icl-rocketry/Ricardo-Garnet/Hardware/Ricardo-Garnet.kicad_pcb

## KiCad design Hardware/Ricardo-Garnet.kicad_pcb (2026-05-12)

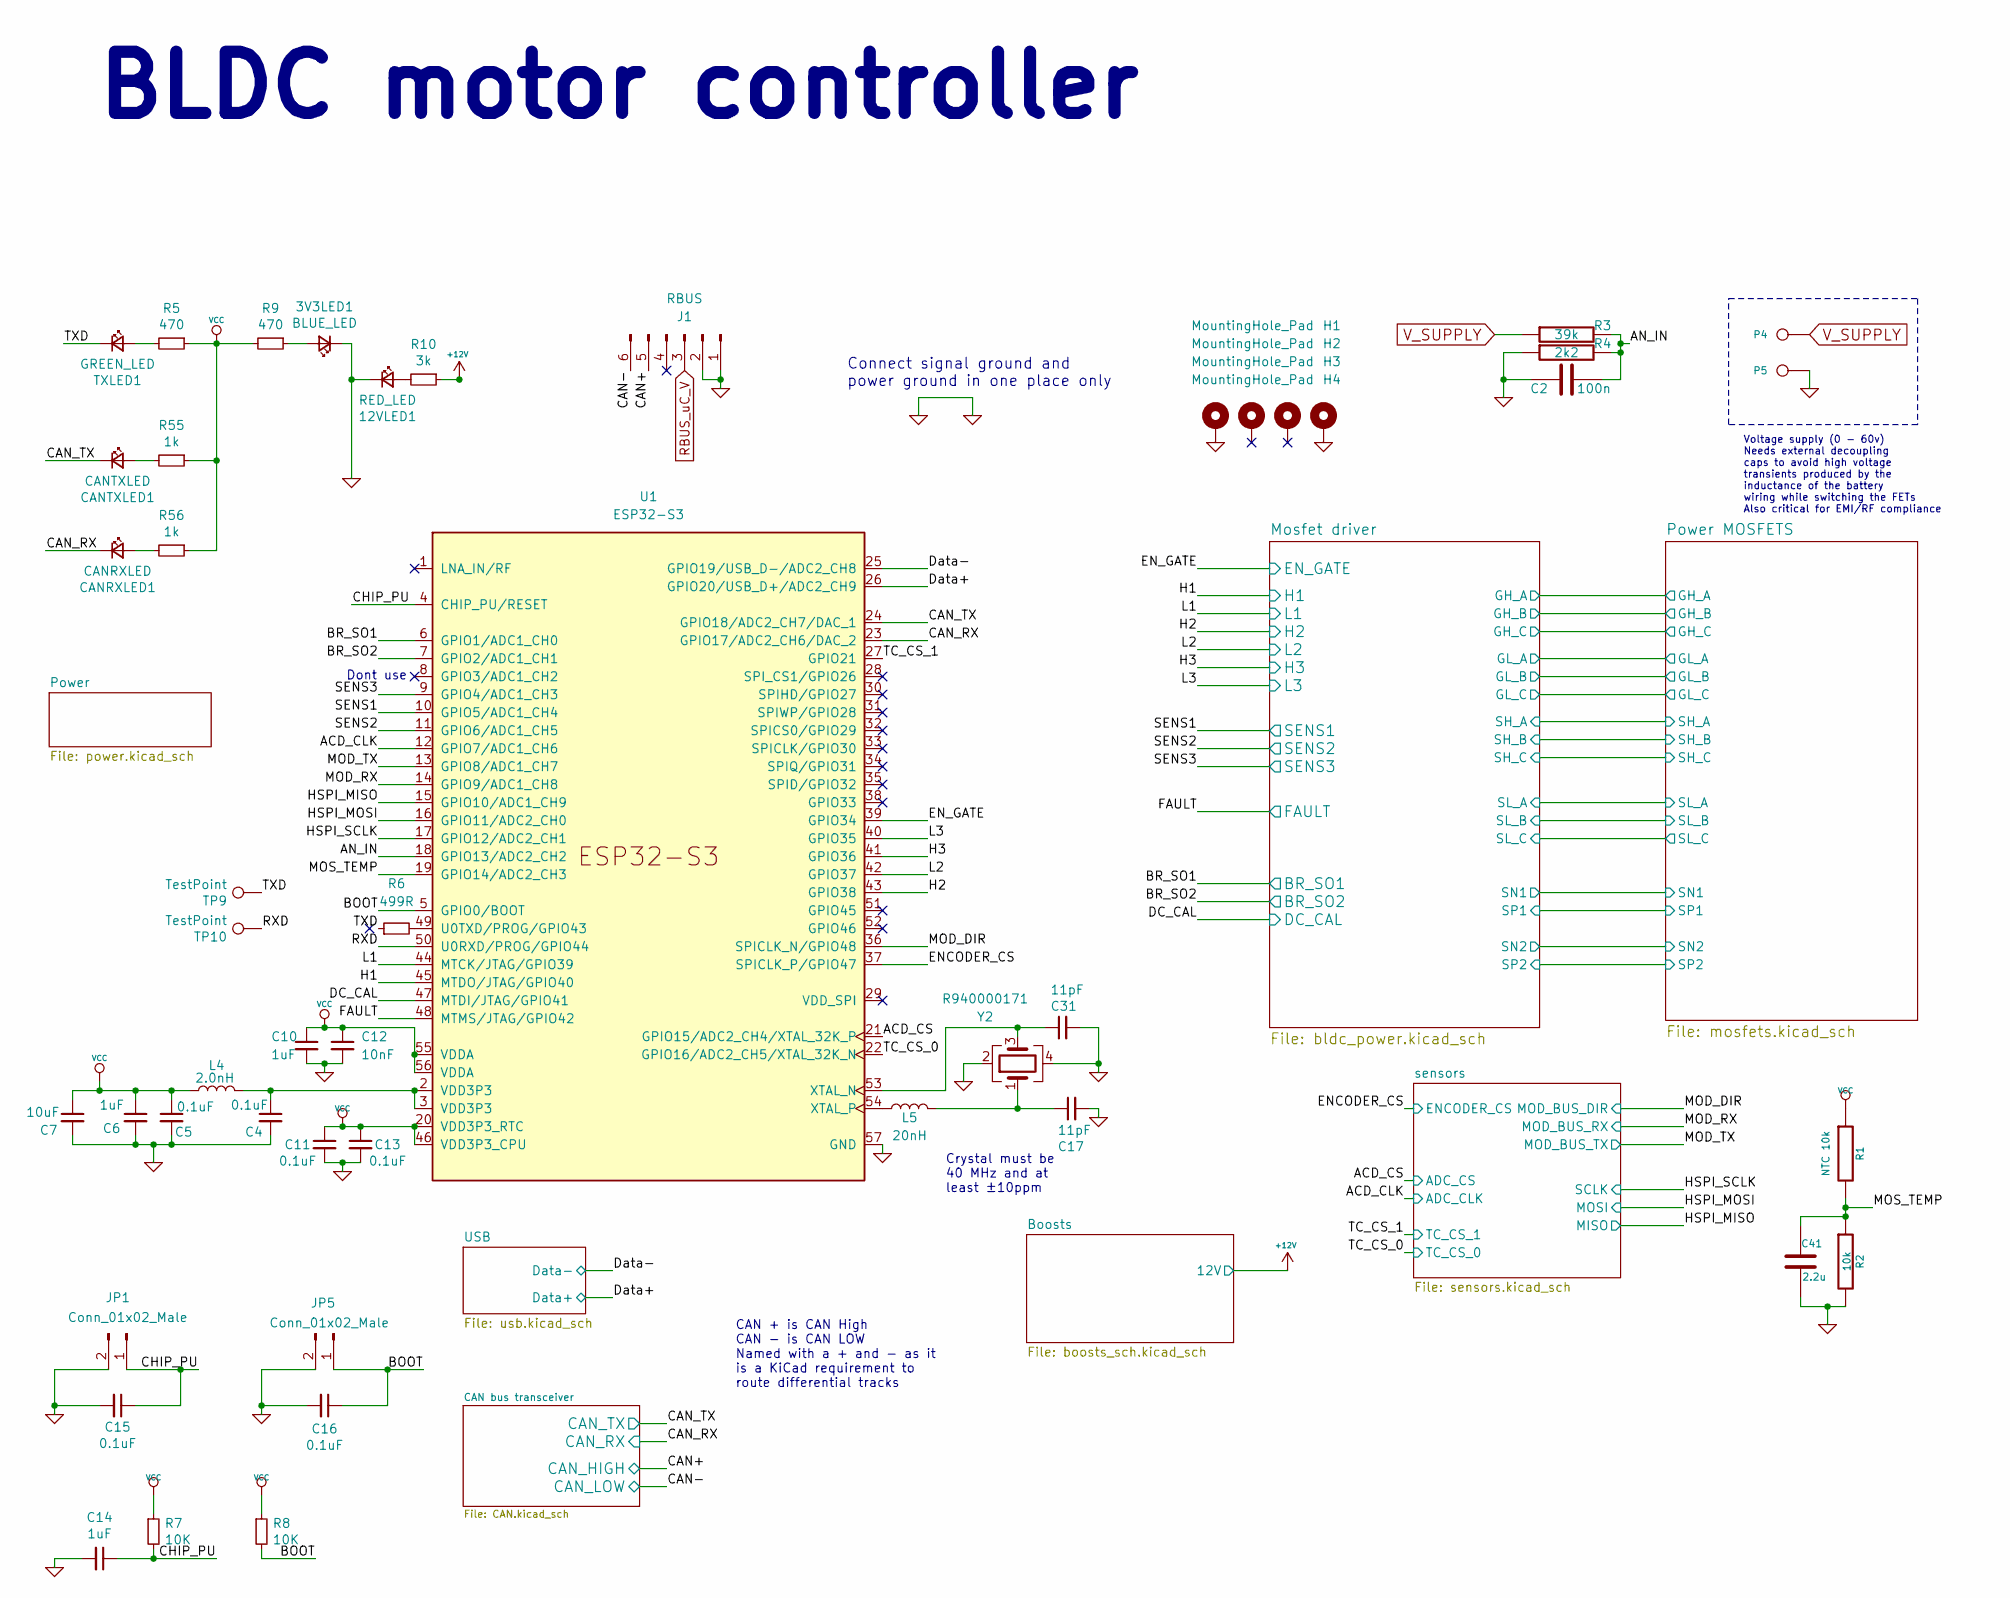
[picture p1: schematic Ricardo-Garnet.kicad_sch]

Parts:
3V3LED1: BLUE_LED; LED_0402_1005Metric
12VLED1: RED_LED; LED_0402_1005Metric
C2: 100n; C_0603_1608Metric
C4, C5, C11, C13, C15, C16: 0.1uF; C_0402_1005Metric
C6, C10, C14: 1uF; C_0402_1005Metric
C7: 10uF; C_0402_1005Metric
C12: 10nF; C_0402_1005Metric
C17, C31: 11pF; C_0402_1005Metric
C41: 2.2u; C_0603_1608Metric
CANRXLED1: CANRXLED; LED_0402_1005Metric
CANTXLED1: CANTXLED; LED_0402_1005Metric
H1, H2, H3, H4: MountingHole_Pad; MountingHole_3.2mm_M3_DIN965_Pad
J1: RBUS; Molex_Mini-Fit_Jr_5569-06A2_2x03_P4.20mm_Horizontal
JP1, JP5: Conn_01x02_Male; PinHeader_1x02_P2.54mm_Vertical
L4: 2.0nH; L_0402_1005Metric
L5: 20nH; L_0402_1005Metric
P4: IN+; 1PAD_4x5mm
P5: IN-; 1PAD_4x5mm
R1: NTC 10k; R_0603_1608Metric
R2: 10k; R_0402_1005Metric
R3: 39k; R_0603_1608Metric
R4: 2k2; R_0402_1005Metric
R5, R9: 470; R_0402_1005Metric
R6: 499R; R_0402_1005Metric
R7, R8: 10K; R_0402_1005Metric
R10: 3k; R_0402_1005Metric
R55, R56: 1k; R_0402_1005Metric
TP9, TP10: TestPoint; TestPoint_Pad_D1.0mm
TXLED1: GREEN_LED; LED_0402_1005Metric
U1: ESP32-S3; QFN40P700X700X90-57N
Y2: R940000171; Crystal_SMD_2016-4Pin_2.0x1.6mm

Connections:
+12V: R10.1; also elsewhere on the board
/ACD_CLK: U1.12 (GPIO7/ADC1_CH6); also elsewhere on the board
/ACD_CS: U1.21 (GPIO15/ADC2_CH4/XTAL_32K_P); also elsewhere on the board
/AN_IN: C2.2, R3.2, R4.2, U1.18 (GPIO13/ADC2_CH2)
/BOOT: C16.1, JP5.1, R8.2, U1.5 (GPIO0/BOOT)
/BR_SO1: U1.6 (GPIO1/ADC1_CH0); also elsewhere on the board
/BR_SO2: U1.7 (GPIO2/ADC1_CH1); also elsewhere on the board
/CAN+: J1.5; also elsewhere on the board
/CAN-: J1.6; also elsewhere on the board
/CAN_RX: CANRXLED1.1 (K), U1.23 (GPIO17/ADC2_CH6/DAC_2); also elsewhere on the board
/CAN_TX: CANTXLED1.1 (K), U1.24 (GPIO18/ADC2_CH7/DAC_1); also elsewhere on the board
/CHIP_PU: C14.1, C15.1, JP1.1, R7.2, U1.4 (CHIP_PU/RESET)
/DC_CAL: U1.47 (MTDI/JTAG/GPIO41); also elsewhere on the board
/Data+: U1.26 (GPIO20/USB_D+/ADC2_CH9); also elsewhere on the board
/Data-: U1.25 (GPIO19/USB_D-/ADC2_CH8); also elsewhere on the board
/ENCODER_CS: U1.37 (SPICLK_P/GPIO47); also elsewhere on the board
/EN_GATE: U1.39 (GPIO34); also elsewhere on the board
/FAULT: U1.48 (MTMS/JTAG/GPIO42); also elsewhere on the board
/H1: U1.45 (MTDO/JTAG/GPIO40); also elsewhere on the board
/H2: U1.43 (GPIO38); also elsewhere on the board
/H3: U1.41 (GPIO36); also elsewhere on the board
/HSPI_MISO: U1.15 (GPIO10/ADC1_CH9); also elsewhere on the board
/HSPI_MOSI: U1.16 (GPIO11/ADC2_CH0); also elsewhere on the board
/HSPI_SCLK: U1.17 (GPIO12/ADC2_CH1); also elsewhere on the board
/L1: U1.44 (MTCK/JTAG/GPIO39); also elsewhere on the board
/L2: U1.42 (GPIO37); also elsewhere on the board
/L3: U1.40 (GPIO35); also elsewhere on the board
/MOD_DIR: U1.36 (SPICLK_N/GPIO48); also elsewhere on the board
/MOD_RX: U1.14 (GPIO9/ADC1_CH8); also elsewhere on the board
/MOD_TX: U1.13 (GPIO8/ADC1_CH7); also elsewhere on the board
/MOS_TEMP: C41.1, R1.2, R2.1, U1.19 (GPIO14/ADC2_CH3)
/RXD: TP10.1, U1.50 (U0RXD/PROG/GPIO44)
/SENS1: U1.10 (GPIO5/ADC1_CH4); also elsewhere on the board
/SENS2: U1.11 (GPIO6/ADC1_CH5); also elsewhere on the board
/SENS3: U1.9 (GPIO4/ADC1_CH3); also elsewhere on the board
/TC_CS_0: U1.22 (GPIO16/ADC2_CH5/XTAL_32K_N); also elsewhere on the board
/TC_CS_1: U1.27 (GPIO21); also elsewhere on the board
/TXD: R6.1, TP9.1, TXLED1.1 (K)
GND: 3V3LED1.1 (K), 12VLED1.1 (K), C2.1, C4.2, C5.2, C6.2, C7.2, C10.2, C11.2, C12.2, C13.2, C14.2, C15.2, C16.2, C17.2, C31.2, C41.2, H1.1, H4.1, J1.1, J1.2, JP1.2, JP5.2, P5.1, R2.2, R4.1, U1.57 (GND), Y2.2, Y2.4; also elsewhere on the board
unnamed: 3V3LED1.2 (A), R9.1
unnamed: 12VLED1.2 (A), R10.2
unnamed: C4.1, L4.2, U1.2 (VDD3P3), U1.3 (VDD3P3)
unnamed: C17.1, L5.2, Y2.1
unnamed: CANRXLED1.2 (A), R56.2
unnamed: CANTXLED1.2 (A), R55.2
unnamed: R5.2, TXLED1.2 (A)
unnamed: R6.2, U1.49 (U0TXD/PROG/GPIO43)
unnamed: C31.1, U1.53 (XTAL_N), Y2.3
unnamed: L5.1, U1.54 (XTAL_P)
RBUS_uC_V: J1.3; also elsewhere on the board
VCC: C5.1, C6.1, C7.1, C10.1, C11.1, C12.1, C13.1, L4.1, R1.1, R5.1, R7.1, R8.1, R9.2, R55.1, R56.1, U1.20 (VDD3P3_RTC), U1.46 (VDD3P3_CPU), U1.55 (VDDA), U1.56 (VDDA); also elsewhere on the board
V_SUPPLY: P4.1, R3.1; also elsewhere on the board

Notes on the sheet:
Connect signal ground and power ground in one place only
Dont use
BLDC motor controller
Voltage supply (0 - 60v) Needs external decoupling caps to avoid high voltage transients produced by the inductance of the battery wiring while switching the FETs Also critical for EMI/RF compliance
CAN + is CAN High CAN - is CAN LOW Named with a + and - as it is a KiCad requirement to route differential tracks
Crystal must be 40 MHz and at least ±10ppm

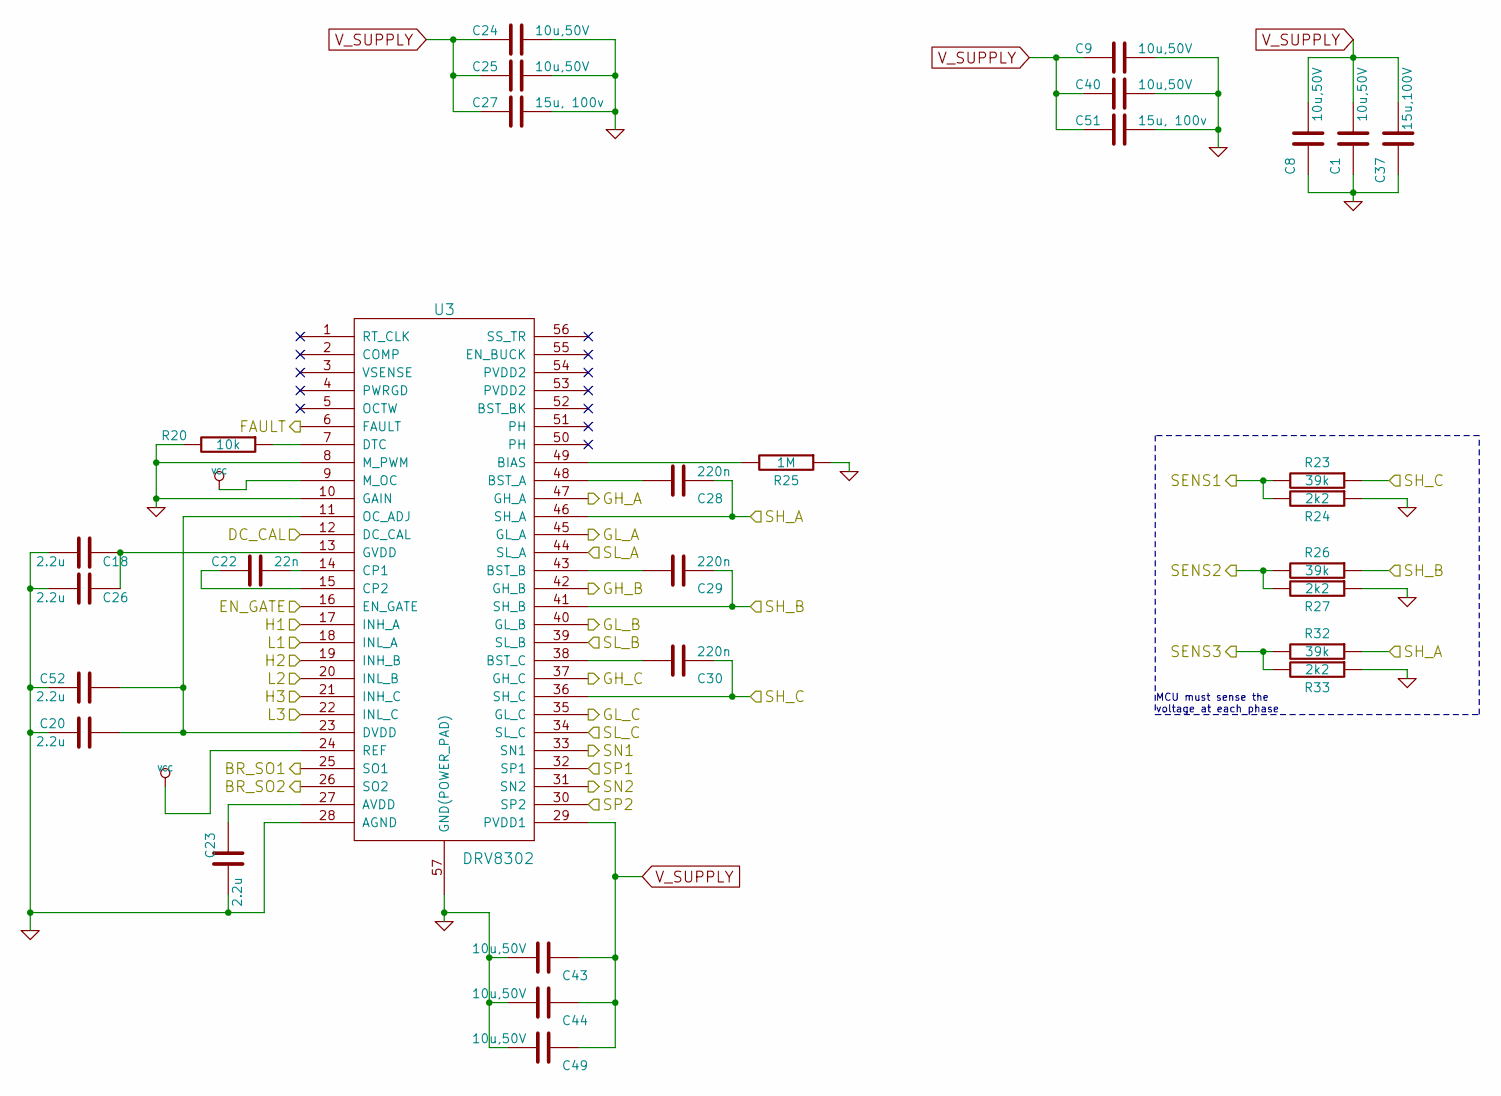
[picture p2: schematic bldc_power.kicad_sch, BLDC Driver 4.11]

Parts:
C1, C8, C9, C24, C25, C40, C43, C44, C49: 10u,50V; C_1206_3216Metric
C18, C20, C23, C26, C52: 2.2u; C_0603_1608Metric
C22: 22n; C_0603_1608Metric
C27, C51: 15u, 100v; C_2220_5750Metric
C28, C29, C30: 220n; C_0603_1608Metric
C37: 15u,100V; C_2220_5750Metric
R20: 10k; R_0402_1005Metric
R23, R26, R32: 39k; R_0603_1608Metric
R24, R27, R33: 2k2; R_0402_1005Metric
R25: 1M; R_0603_1608Metric
U3: DRV8302; TSSOP-56-PP

Connections:
/BR_SO1: U3.25 (SO1); also elsewhere on the board
/BR_SO2: U3.26 (SO2); also elsewhere on the board
/DC_CAL: U3.12 (DC_CAL); also elsewhere on the board
/EN_GATE: U3.16 (EN_GATE); also elsewhere on the board
/FAULT: U3.6 (FAULT); also elsewhere on the board
/H1: U3.17 (INH_A); also elsewhere on the board
/H2: U3.19 (INH_B); also elsewhere on the board
/H3: U3.21 (INH_C); also elsewhere on the board
/L1: U3.18 (INL_A); also elsewhere on the board
/L2: U3.20 (INL_B); also elsewhere on the board
/L3: U3.22 (INL_C); also elsewhere on the board
/Mosfet driver/GH_A: U3.47 (GH_A); also elsewhere on the board
/Mosfet driver/GH_B: U3.42 (GH_B); also elsewhere on the board
/Mosfet driver/GH_C: U3.37 (GH_C); also elsewhere on the board
/Mosfet driver/GL_A: U3.45 (GL_A); also elsewhere on the board
/Mosfet driver/GL_B: U3.40 (GL_B); also elsewhere on the board
/Mosfet driver/GL_C: U3.35 (GL_C); also elsewhere on the board
/Mosfet driver/SH_A: C28.1, R32.1, U3.46 (SH_A); also elsewhere on the board
/Mosfet driver/SH_B: C29.1, R26.1, U3.41 (SH_B); also elsewhere on the board
/Mosfet driver/SH_C: C30.1, R23.1, U3.36 (SH_C); also elsewhere on the board
/Mosfet driver/SL_A: U3.44 (SL_A); also elsewhere on the board
/Mosfet driver/SL_C: U3.34 (SL_C); also elsewhere on the board
/Mosfet driver/SN1: U3.33 (SN1); also elsewhere on the board
/Mosfet driver/SN2: U3.31 (SN2); also elsewhere on the board
/Mosfet driver/SP1: U3.32 (SP1); also elsewhere on the board
/Mosfet driver/SP2: U3.30 (SP2); also elsewhere on the board
/SENS1: R23.2, R24.2; also elsewhere on the board
/SENS2: R26.2, R27.2; also elsewhere on the board
/SENS3: R32.2, R33.2; also elsewhere on the board
GND: C1.1, C8.1, C9.1, C18.1, C20.1, C23.1, C24.1, C25.1, C26.1, C27.1, C37.1, C40.1, C43.2, C44.2, C49.2, C51.1, C52.1, R20.2, R24.1, R25.1, R27.1, R33.1, U3.8 (M_PWM), U3.10 (GAIN), U3.28 (AGND), U3.39 (SL_B), U3.57 (GND(POWER_PAD)); also elsewhere on the board
unnamed: C23.2, U3.27 (AVDD)
unnamed: R25.2, U3.49 (BIAS)
unnamed: C28.2, U3.48 (BST_A)
unnamed: C29.2, U3.43 (BST_B)
unnamed: C30.2, U3.38 (BST_C)
unnamed: C22.1, U3.14 (CP1)
unnamed: C22.2, U3.15 (CP2)
unnamed: R20.1, U3.7 (DTC)
unnamed: C20.2, C52.2, U3.11 (OC_ADJ), U3.23 (DVDD)
unnamed: C18.2, C26.2, U3.13 (GVDD)
VCC: U3.9 (M_OC), U3.24 (REF); also elsewhere on the board
V_SUPPLY: C1.2, C8.2, C9.2, C24.2, C25.2, C27.2, C37.2, C40.2, C43.1, C44.1, C49.1, C51.2, U3.29 (PVDD1); also elsewhere on the board

Notes on the sheet:
MCU must sense the voltage at each phase

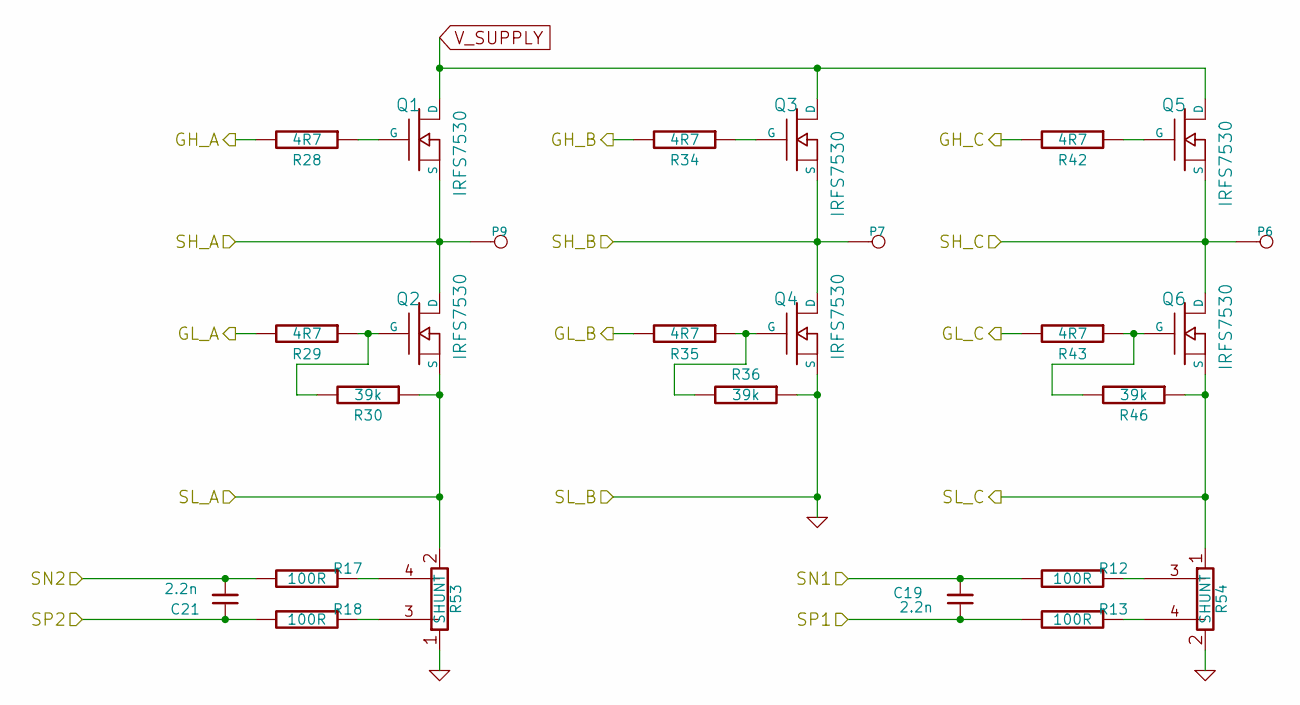
[picture p3: schematic mosfets.kicad_sch, BLDC Driver 4.11]

Parts:
C19, C21: 2.2n; C_0603_1608Metric
P6: MOTOR1; 1PAD_4x5mm
P7: MOTOR2; 1PAD_4x5mm
P9: MOTOR3; 1PAD_4x5mm
Q1, Q2, Q3, Q4, Q5, Q6: IRFS7530; D2PAK-7-GDS
R12, R13, R17, R18: 100R; R_0603_1608Metric
R28, R29, R34, R35, R42, R43: 4R7; R_0603_1608Metric
R30, R36, R46: 39k; R_0603_1608Metric
R53, R54: SHUNT; WSLP2726

Connections:
/Mosfet driver/GH_A: R28.2; also elsewhere on the board
/Mosfet driver/GH_B: R34.2; also elsewhere on the board
/Mosfet driver/GH_C: R42.2; also elsewhere on the board
/Mosfet driver/GL_A: R29.2; also elsewhere on the board
/Mosfet driver/GL_B: R35.2; also elsewhere on the board
/Mosfet driver/GL_C: R43.2; also elsewhere on the board
/Mosfet driver/SH_A: P9.1, Q1.S, Q2.D; also elsewhere on the board
/Mosfet driver/SH_B: P7.1, Q3.S, Q4.D; also elsewhere on the board
/Mosfet driver/SH_C: P6.1, Q5.S, Q6.D; also elsewhere on the board
/Mosfet driver/SL_A: Q2.S, R30.1, R53.2; also elsewhere on the board
/Mosfet driver/SL_C: Q6.S, R46.1, R54.1; also elsewhere on the board
/Mosfet driver/SN1: C19.2, R12.2; also elsewhere on the board
/Mosfet driver/SN2: C21.2, R17.2; also elsewhere on the board
/Mosfet driver/SP1: C19.1, R13.2; also elsewhere on the board
/Mosfet driver/SP2: C21.1, R18.2; also elsewhere on the board
GND: Q4.S, R36.1, R53.1, R54.2; also elsewhere on the board
unnamed: Q1.G, R28.1
unnamed: Q2.G, R29.1, R30.2
unnamed: Q3.G, R34.1
unnamed: Q4.G, R35.1, R36.2
unnamed: Q5.G, R42.1
unnamed: Q6.G, R43.1, R46.2
unnamed: R12.1, R54.3
unnamed: R13.1, R54.4
unnamed: R17.1, R53.4
unnamed: R18.1, R53.3
V_SUPPLY: Q1.D, Q3.D, Q5.D; also elsewhere on the board

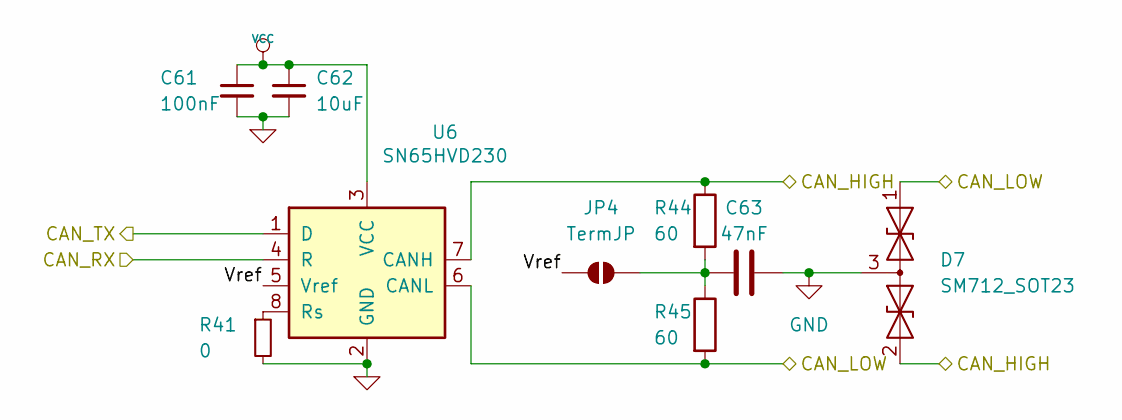
[picture p4: schematic CAN.kicad_sch, BLDC Driver 4.11]

Parts:
C61: 100nF; C_0402_1005Metric
C62: 10uF; C_0402_1005Metric
C63: 47nF; C_0402_1005Metric
D7: SM712_SOT23; SOT-23
JP4: TermJP; SmallerSolderJP
R41: 0; R_0603_1608Metric
R44, R45: 60; R_0603_1608Metric
U6: SN65HVD230; SOIC-8_3.9x4.9mm_P1.27mm

Connections:
/CAN bus transceiver/Vref: JP4.1 (A), U6.5 (Vref)
/CAN+: D7.2 (A2), R44.1, U6.7 (CANH); also elsewhere on the board
/CAN-: D7.1 (A1), R45.2, U6.6 (CANL); also elsewhere on the board
/CAN_RX: U6.4 (R); also elsewhere on the board
/CAN_TX: U6.1 (D); also elsewhere on the board
GND: C61.2, C62.2, C63.2, D7.3 (common), R41.2, U6.2 (GND); also elsewhere on the board
unnamed: C63.1, JP4.2 (B), R44.2, R45.1
unnamed: R41.1, U6.8 (Rs)
VCC: C61.1, C62.1, U6.3 (VCC); also elsewhere on the board

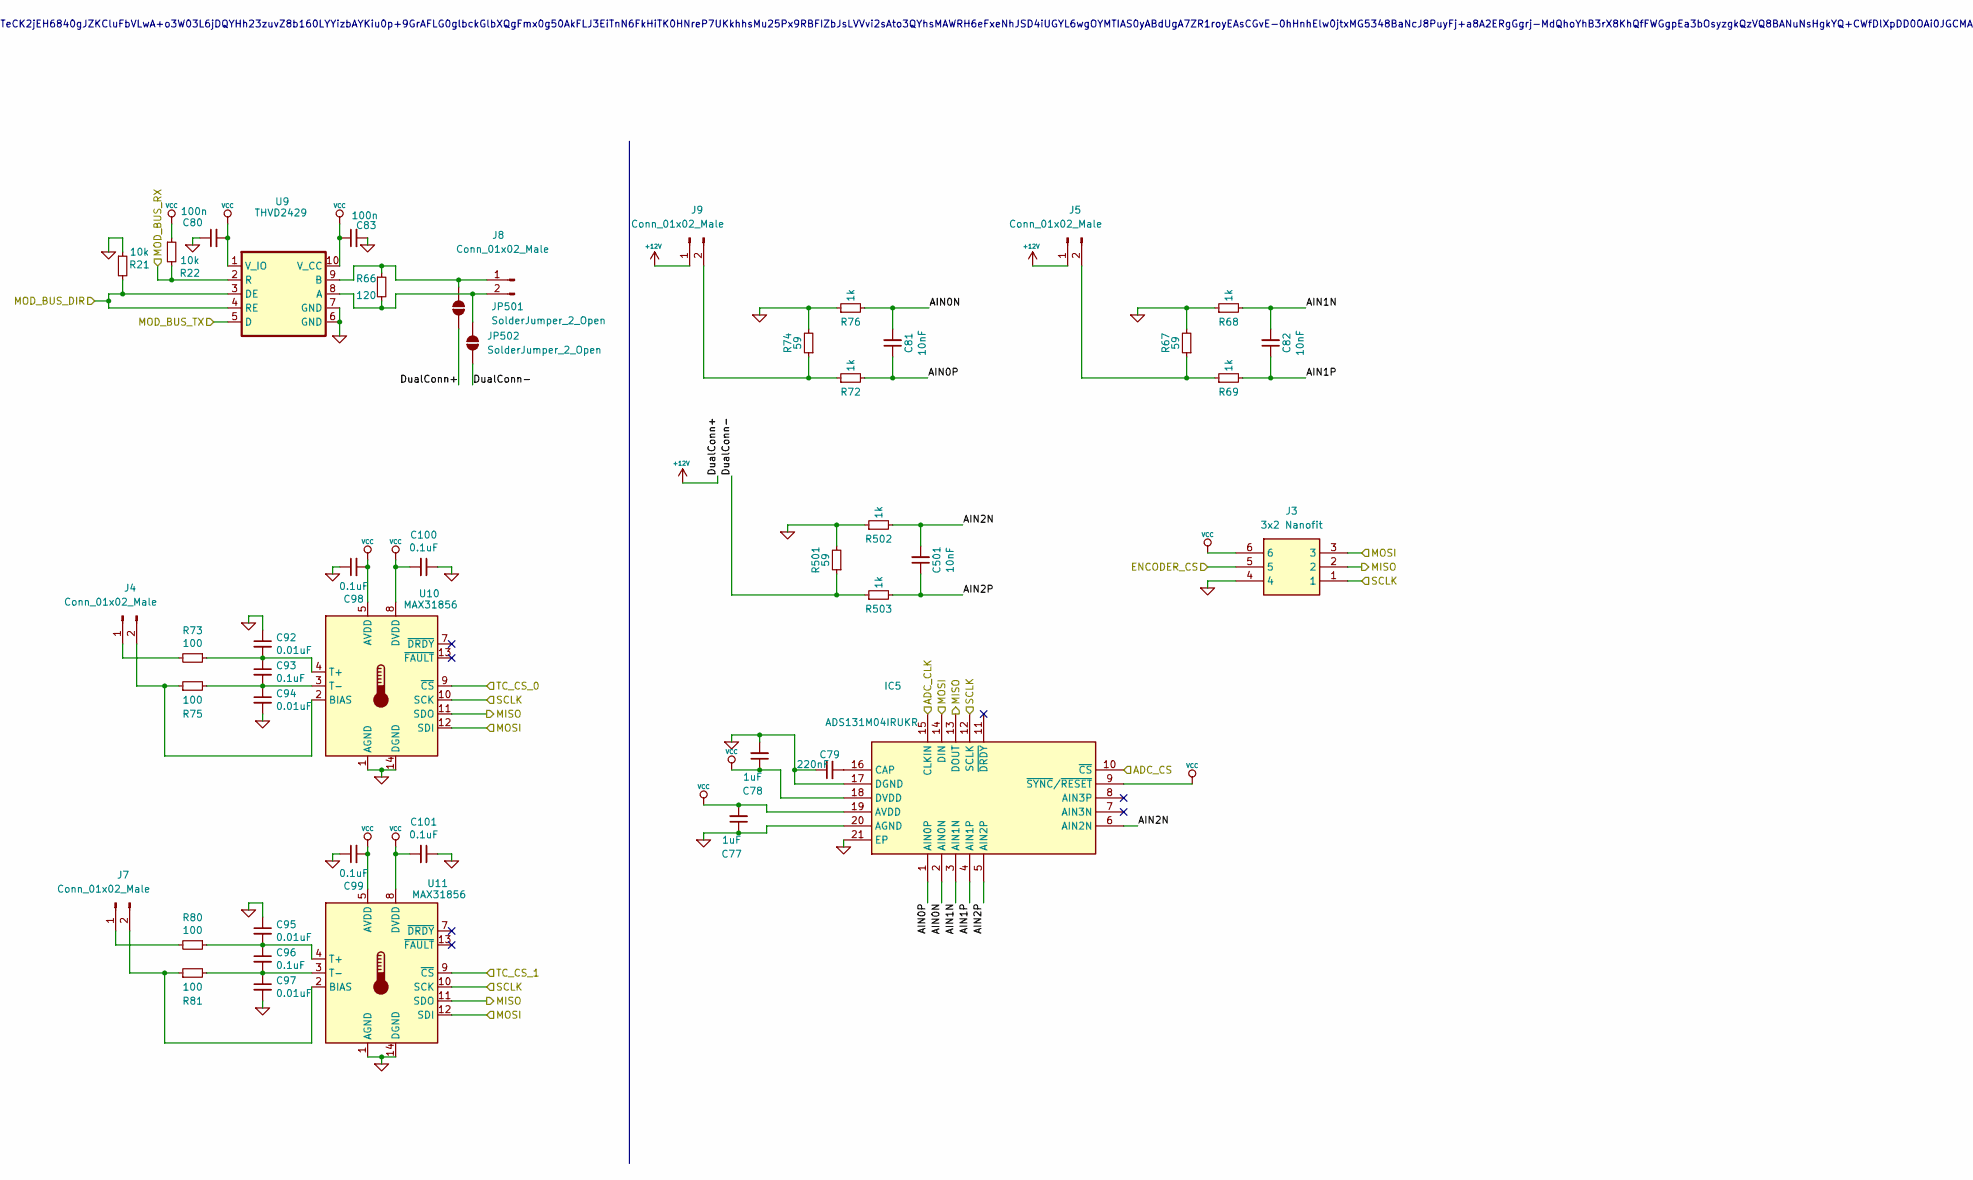
[picture p5: schematic sensors.kicad_sch, part in row 1, column 3]

Parts:
C77, C78: 1uF; C_0402_1005Metric
C79: 220nF; C_0402_1005Metric
C80, C83: 100n; C_0402_1005Metric
C81, C82, C501: 10nF; C_0402_1005Metric
C92, C94, C95, C97: 0.01uF; C_0402_1005Metric
C93, C96, C98, C99, C100, C101: 0.1uF; C_0402_1005Metric
IC5: ADS131M04IRUKR; QFN40P300X300X80-21N-D; Manufacturer_Part_Number ADS131M04IRUKR; Mouser Part Number 595-ADS131M04IRUKR
J3: 3x2 Nanofit; Molex_Nano-Fit_105314-xx06_2x03_P2.50mm_Horizontal; Mouser Part Number 538-105314-1206
J4, J5, J7, J8, J9: Conn_01x02_Male; Molex_Nano-Fit_105313-xx02_1x02_P2.50mm_Horizontal
JP501, JP502: SolderJumper_2_Open; small_2_pad_jumper_open
R21, R22: 10k; R_0402_1005Metric
R66: 120; R_0402_1005Metric
R67, R74, R501: 59; R_0402_1005Metric; MPN RT0402BRD0749R9L
R68, R69, R72, R76, R502, R503: 1k; R_0402_1005Metric
R73, R75, R80, R81: 100; R_0402_1005Metric
U9: THVD2429; TPS74901DRCR
U10, U11: MAX31856; TSSOP-14_4.4x5mm_P0.65mm

Connections:
+12V: J5.1, J9.1, JP501.1 (A); also elsewhere on the board
/ACD_CLK: IC5.15 (CLKIN); also elsewhere on the board
/ACD_CS: IC5.10 (~CS); also elsewhere on the board
/ENCODER_CS: J3.5; also elsewhere on the board
/HSPI_MISO: IC5.13 (DOUT), J3.2, U10.11 (SDO), U11.11 (SDO); also elsewhere on the board
/HSPI_MOSI: IC5.14 (DIN), J3.3, U10.12 (SDI), U11.12 (SDI); also elsewhere on the board
/HSPI_SCLK: IC5.12 (SCLK), J3.1, U10.10 (SCK), U11.10 (SCK); also elsewhere on the board
/MOD_DIR: R21.2, U9.3 (DE), U9.4 (RE); also elsewhere on the board
/MOD_RX: R22.2, U9.2 (R); also elsewhere on the board
/MOD_TX: U9.5 (D); also elsewhere on the board
/TC_CS_0: U10.9 (~CS); also elsewhere on the board
/TC_CS_1: U11.9 (~CS); also elsewhere on the board
/sensors/AIN0N: C81.2, IC5.2 (AIN0N), R76.2
/sensors/AIN0P: C81.1, IC5.1 (AIN0P), R72.2
/sensors/AIN1N: C82.2, IC5.3 (AIN1N), R68.2
/sensors/AIN1P: C82.1, IC5.4 (AIN1P), R69.2
/sensors/AIN2N: C501.2, IC5.6 (AIN2N), R502.2
/sensors/AIN2P: C501.1, IC5.5 (AIN2P), R503.2
/sensors/DualConn-: JP502.1 (A), R501.1, R503.1
GND: C77.1, C78.2, C79.1, C80.1, C83.2, C92.1, C94.2, C95.1, C97.2, C98.1, C99.1, C100.1, C101.1, IC5.17 (DGND), IC5.20 (AGND), IC5.21 (EP), J3.4, R21.1, R67.2, R68.1, R74.2, R76.1, R501.2, R502.1, U9.6 (GND), U9.7 (GND), U10.1 (AGND), U10.14 (DGND), U11.1 (AGND), U11.14 (DGND); also elsewhere on the board
unnamed: C79.2, IC5.16 (CAP)
unnamed: J4.1, R73.2
unnamed: J4.2, R75.1, U10.2 (BIAS)
unnamed: J5.2, R67.1, R69.1
unnamed: J7.1, R80.2
unnamed: J7.2, R81.1, U11.2 (BIAS)
unnamed: J8.1, JP501.2 (B), R66.1, U9.9 (B)
unnamed: J8.2, JP502.2 (B), R66.2, U9.8 (A)
unnamed: J9.2, R72.1, R74.1
unnamed: C92.2, C93.1, R73.1, U10.4 (T+)
unnamed: C93.2, C94.1, R75.2, U10.3 (T-)
unnamed: C95.2, C96.1, R80.1, U11.4 (T+)
unnamed: C96.2, C97.1, R81.2, U11.3 (T-)
VCC: C77.2, C78.1, C80.2, C83.1, C98.2, C99.2, C100.2, C101.2, IC5.9 (~SYNC/~RESET), IC5.18 (DVDD), IC5.19 (AVDD), J3.6, R22.1, U9.1 (V_IO), U9.10 (V_CC), U10.5 (AVDD), U10.8 (DVDD), U11.5 (AVDD), U11.8 (DVDD); also elsewhere on the board

Notes on the sheet:
https://www.falstad.com/circuit/circuitjs.html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…

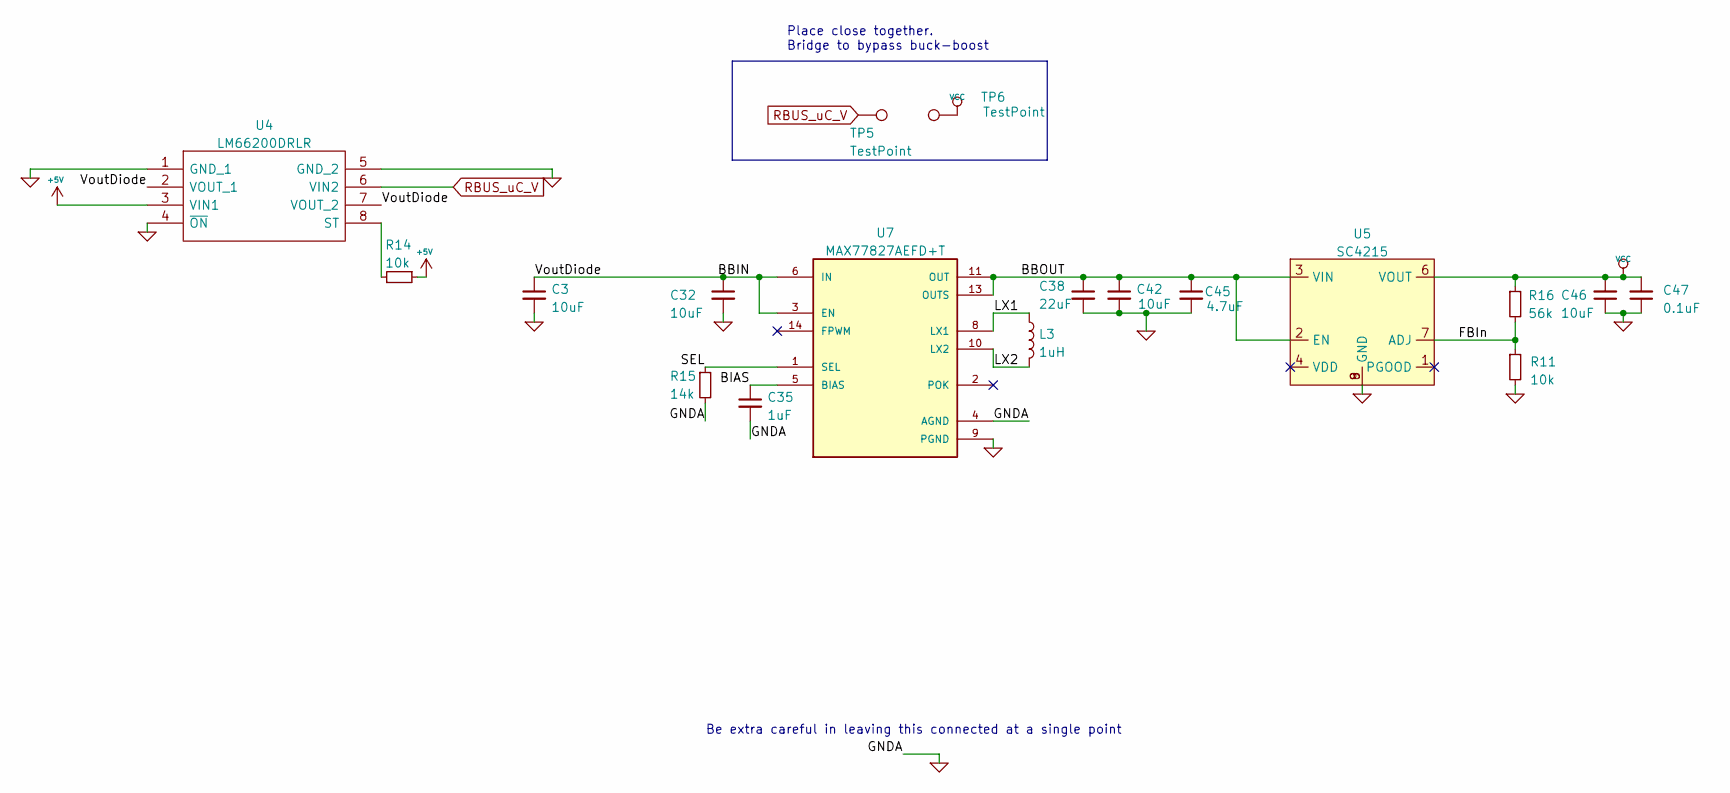
[picture p6: schematic power.kicad_sch]

Parts:
C3, C42, C46: 10uF; C_0402_1005Metric
C32: 10uF; C_0603_1608Metric
C35: 1uF; C_0402_1005Metric
C38: 22uF; C_0603_1608Metric
C45: 4.7uF; C_0402_1005Metric
C47: 0.1uF; C_0402_1005Metric
L3: 1uH; L_0805_2012Metric
R11, R14: 10k; R_0402_1005Metric
R15: 14k; R_0402_1005Metric
R16: 56k; R_0402_1005Metric
TP5, TP6: TestPoint; TestPoint_Pad_D1.5mm
U4: LM66200DRLR; SOTFL50P160X60-8N; Manufacturer_Part_Number LM66200DRLR; Mouser Part Number 595-LM66200DRLR
U5: SC4215; SOIC127P599X175-9N
U7: MAX77827AEFD+T; CONV_MAX77827AEFD+T; PARTREV B

Connections:
+5V: R14.1, U4.3 (VIN1); also elsewhere on the board
/Power/BBIN: C3.1, C32.1, U4.2 (VOUT_1), U4.7 (VOUT_2), U7.3 (EN), U7.6 (IN)
/Power/BBOUT: C38.1, C42.1, C45.1, U5.2 (EN), U5.3 (VIN), U7.11 (OUT), U7.13 (OUTS)
/Power/BIAS: C35.1, U7.5 (BIAS)
/Power/FBIn: R11.1, R16.2, U5.7 (ADJ)
/Power/LX1: L3.1, U7.8 (LX1)
/Power/LX2: L3.2, U7.10 (LX2)
/Power/SEL: R15.1, U7.1 (SEL)
GND: C3.2, C32.2, C35.2, C38.2, C42.2, C45.2, C46.1, C47.1, R11.2, R15.2, U4.1 (GND_1), U4.4 (~ON), U4.5 (GND_2), U5.8 (GND), U5.9 (GND), U7.4 (AGND), U7.9 (PGND); also elsewhere on the board
unnamed: R14.2, U4.8 (ST)
RBUS_uC_V: TP5.1, U4.6 (VIN2); also elsewhere on the board
VCC: C46.2, C47.2, R16.1, TP6.1, U5.6 (VOUT); also elsewhere on the board

Notes on the sheet:
Be extra careful in leaving this connected at a single point
Place close together. Bridge to bypass buck-boost

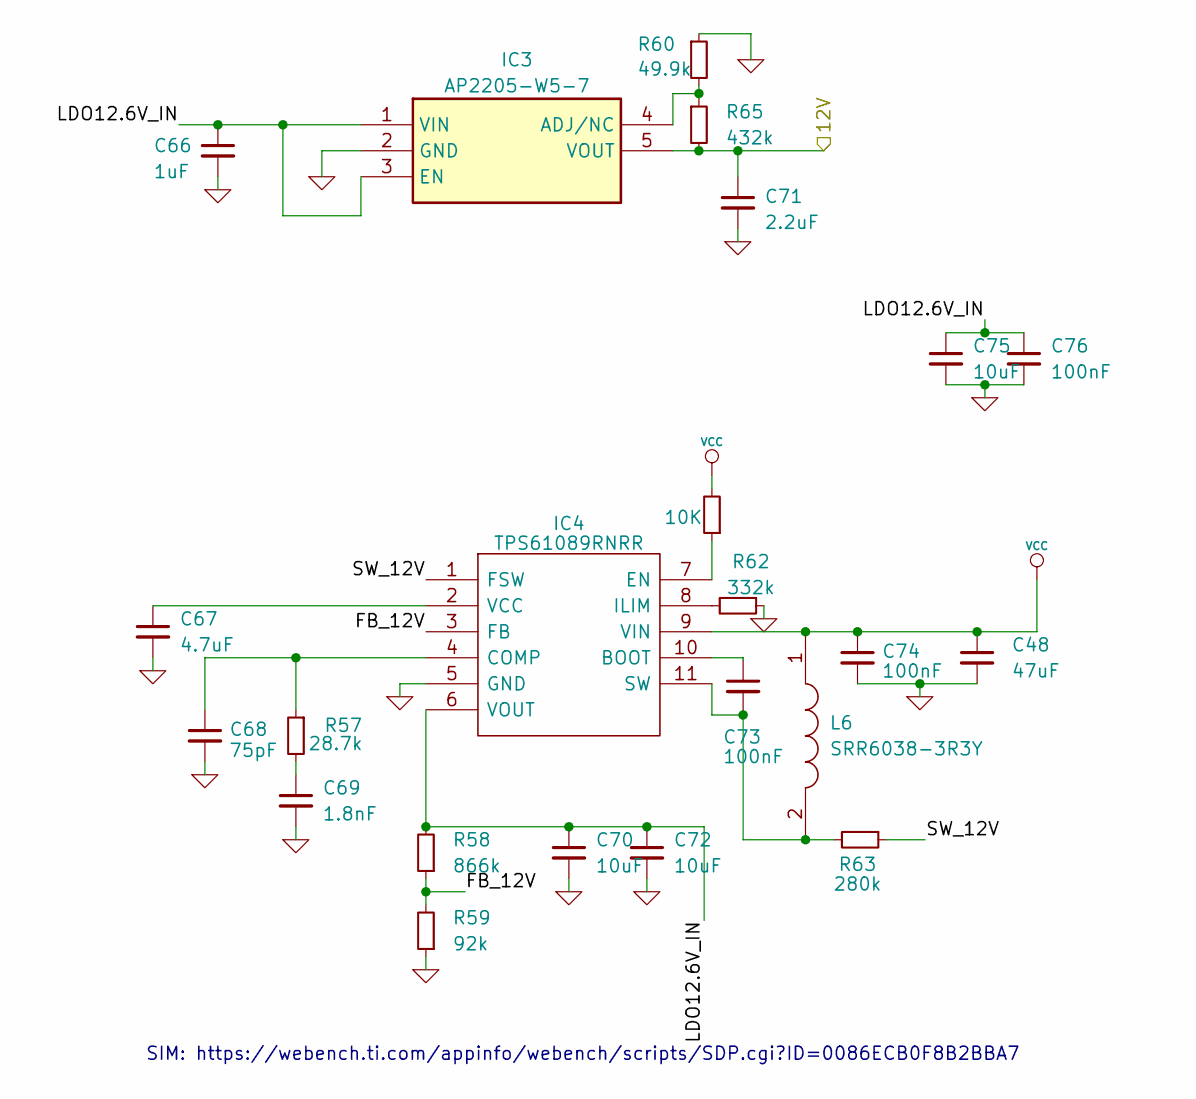
[picture p7: schematic boosts_sch.kicad_sch]

Parts:
C48: 47uF; C_1206_3216Metric
C66: 1uF; C_0402_1005Metric; MPN CL05X105KA5NQNC
C67: 4.7uF; C_0603_1608Metric
C68: 75pF; C_0402_1005Metric
C69: 1.8nF; C_0402_1005Metric
C70, C72: 10uF; C_0805_2012Metric
C71: 2.2uF; C_0402_1005Metric; MPN GRM155R61E225ME15D
C73, C74: 100nF; C_0402_1005Metric
C75: 10uF; C_0603_1608Metric; MPN TMK107BBJ106MA-T
C76: 100nF; C_0402_1005Metric; MPN C1005X5R1E104KT000E
IC3: AP2205-W5-7; SOT95P282X145-5N; Mouser Part Number 621-AP2205-W5-7
IC4: TPS61089RNRR; IC_TPS61089RNRR; Manufacturer_Part_Number TPS61089RNRR; Mouser Part Number 595-TPS61089RNRR
L6: SRR6038-3R3Y; IND_SRP6540-390M; Manufacturer_Part_Number SRR6038-5R0Y; Mouser Part Number 652-SRR6038-5R0Y
R57: 28.7k; R_0402_1005Metric
R58: 866k; R_0402_1005Metric
R59: 92k; R_0402_1005Metric
R60: 49.9k; R_0402_1005Metric
R61: 10K; R_0402_1005Metric
R62: 332k; R_0402_1005Metric
R63: 280k; R_0402_1005Metric
R65: 432k; R_0402_1005Metric

Connections:
+12V: C71.1, IC3.5 (VOUT), R65.2; also elsewhere on the board
/Boosts/FB_12V: IC4.3 (FB), R58.1, R59.2
/Boosts/LDO12.6V_IN: C66.1, C70.1, C72.1, C75.1, C76.1, IC3.1 (VIN), IC3.3 (EN), IC4.6 (VOUT), R58.2
/Boosts/SW_12V: IC4.1 (FSW), R63.1
GND: C48.2, C66.2, C67.2, C68.2, C69.2, C70.2, C71.2, C72.2, C74.2, C75.2, C76.2, IC3.2 (GND), IC4.5 (GND), R59.1, R60.1, R62.1; also elsewhere on the board
unnamed: C69.1, R57.2
unnamed: IC3.4 (ADJ/NC), R60.2, R65.1
unnamed: C73.1, IC4.10 (BOOT)
unnamed: C68.1, IC4.4 (COMP), R57.1
unnamed: IC4.7 (EN), R61.1
unnamed: IC4.8 (ILIM), R62.2
unnamed: C73.2, IC4.11 (SW), L6.2, R63.2
unnamed: C67.1, IC4.2 (VCC)
VCC: C48.1, C74.1, IC4.9 (VIN), L6.1, R61.2; also elsewhere on the board

Notes on the sheet:
SIM: https://webench.ti.com/appinfo/webench/scripts/SDP.cgi?ID=0086ECB0F8B2BBA7

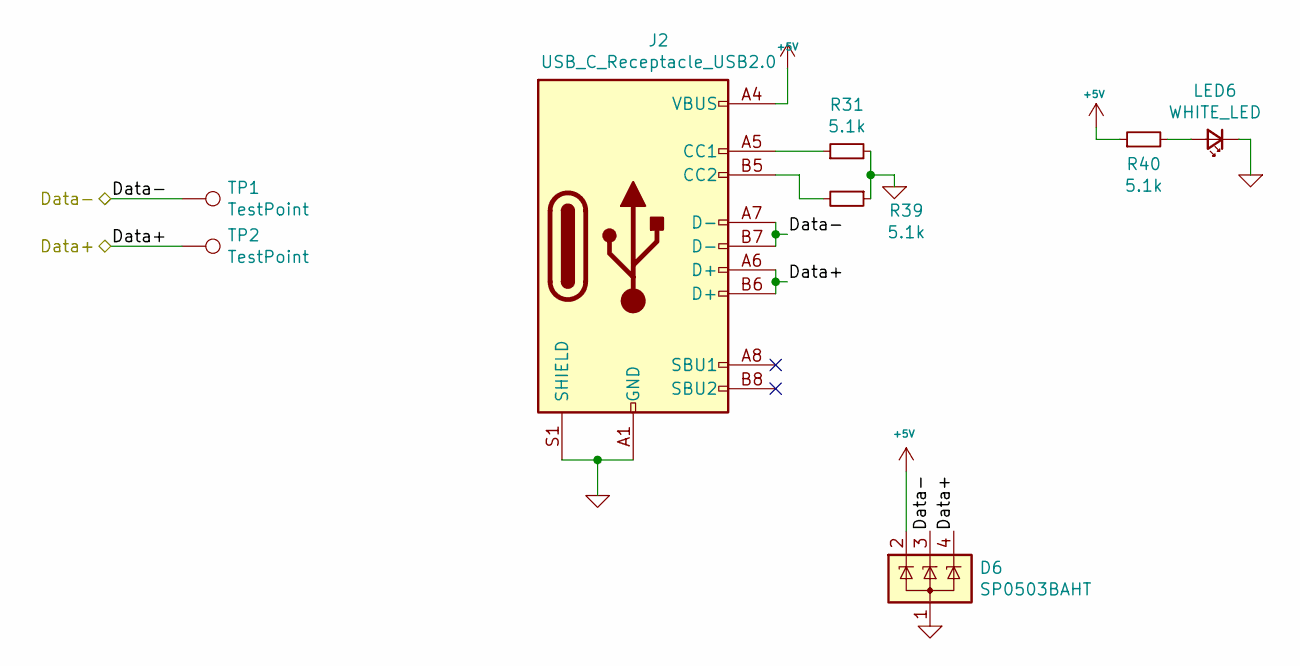
[picture p8: schematic usb.kicad_sch]

Parts:
D6: SP0503BAHT; SOT-143
J2: USB_C_Receptacle_USB2.0; USB_C_Receptacle_Palconn_UTC16-G
LED6: WHITE_LED; LED_0402_1005Metric
R31, R39, R40: 5.1k; R_0402_1005Metric
TP1, TP2: TestPoint; TestPoint_Pad_D1.0mm

Connections:
+5V: D6.2 (K), J2.A4 (VBUS), J2.A9 (VBUS), J2.B4 (VBUS), J2.B9 (VBUS), R40.1; also elsewhere on the board
/Data+: D6.4 (K), J2.A6 (D+), J2.B6 (D+), TP2.1; also elsewhere on the board
/Data-: D6.3 (K), J2.A7 (D-), J2.B7 (D-), TP1.1; also elsewhere on the board
GND: D6.1 (A), J2.A1 (GND), J2.A12 (GND), J2.B1 (GND), J2.B12 (GND), J2.S1 (SHIELD), LED6.1 (K), R31.2, R39.1; also elsewhere on the board
unnamed: J2.A5 (CC1), R31.1
unnamed: J2.B5 (CC2), R39.2
unnamed: LED6.2 (A), R40.2
