icl-rocketry/Ricardo-Garnet/Hardware/Ricardo-Garnet.kicad_pcb

## KiCad design Hardware/Ricardo-Garnet.kicad_pcb (continued)

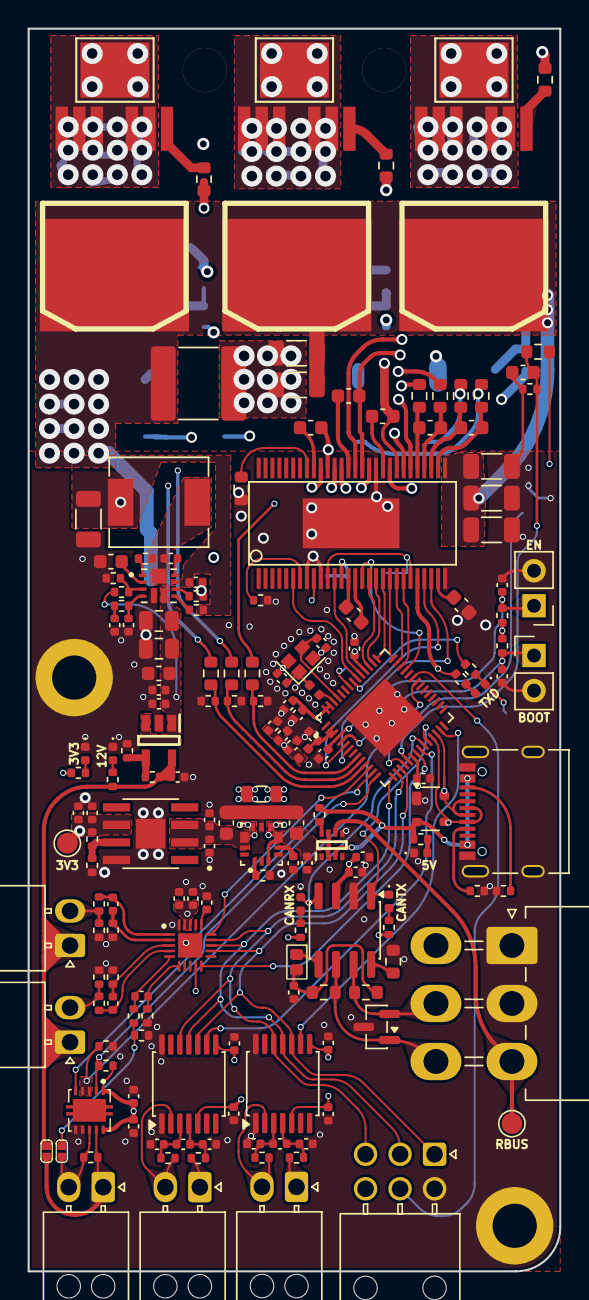
[picture p9: board Ricardo-Garnet.kicad_pcb from above]

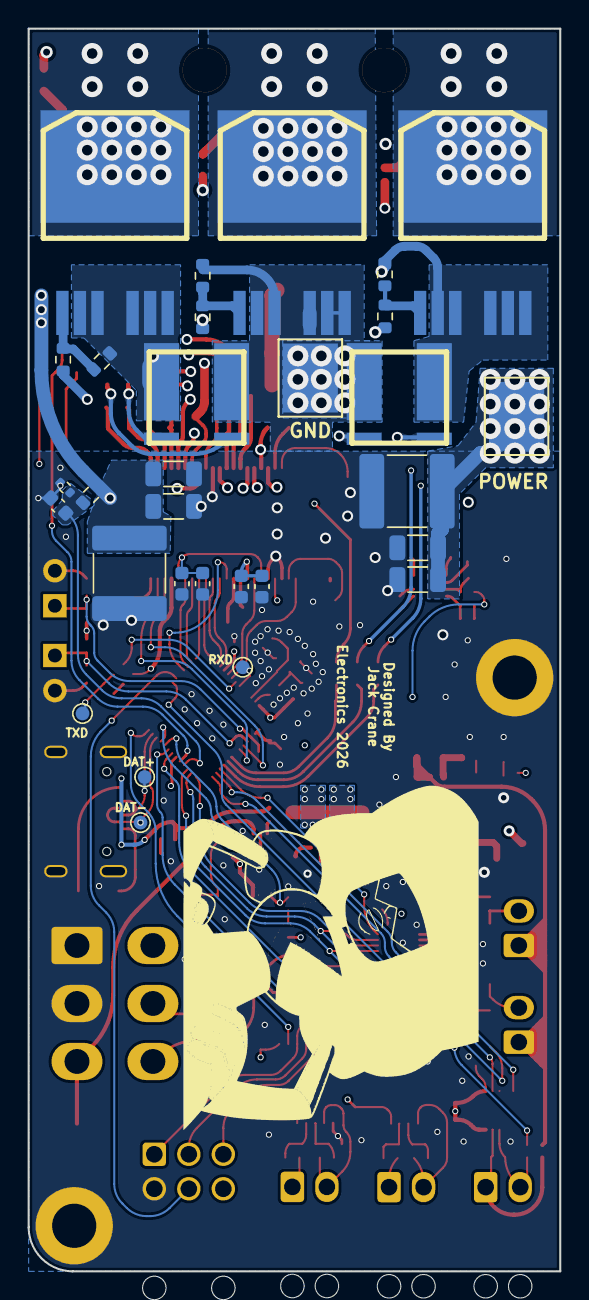
[picture p10: board Ricardo-Garnet.kicad_pcb from below]

Board: 4 copper layers, 38.5 x 90.0 mm, 207 parts (30 on the bottom side), 133 nets.
