icl-rocketry/Ricardo-Garnet/(commit log)

2026-01-19 initial commit for schematic review
    [BLDC_4-2026-01-04-20-25-04.sch, CAN-2026-01-04-20-25-04.sch, CAN.kicad_sch, Power-2026-01-04-20-25-04.sch, Ricardo-Garnet.kicad_pcb, Ricardo-Garnet.kicad_sch, STM32F4 64LQFP-2026-01-04-20-25-04.sch, bldc_power.kicad_sch]
2026-01-20 removed voltage pt sensing capabilities
    [Ricardo-Garnet.kicad_sch, boosts_sch.kicad_sch, sensors.kicad_sch]
2026-01-27 chatting to fang
    [Ricardo-Garnet.kicad_pcb, Ricardo-Garnet.kicad_sch, bldc_power.kicad_sch, mosfets.kicad_sch, power.kicad_sch, sensors.kicad_sch]
2026-01-29 updated settled pcb design
    [Ricardo-Garnet.kicad_pcb, Ricardo-Garnet.kicad_sch, sensors.kicad_sch]
2026-02-05 close to 1st done
    [Ricardo-Garnet.kicad_pcb, Ricardo-Garnet.kicad_sch, bldc_power.kicad_sch, mosfets.kicad_sch]
2026-02-11 final touches and adding encoder
    [Ricardo-Garnet.kicad_pcb, Ricardo-Garnet.kicad_sch, bldc_power.kicad_sch, sensors.kicad_sch]
2026-03-21 removed some decoupling caps from sims
    [Bootstrap.kicad_sch, Bootstrap_controllable.kicad_sch, Complex_Half_Bridge.kicad_sch, Full_Sim.kicad_sch, Half_Bridge.kicad_sch, PWM.kicad_sch, Ricardo-Garnet.kicad_pcb, Simple_Half_Bridge.kicad_sch]
2026-03-21 mounting holes looking rough
    [Ricardo-Garnet.kicad_pcb, Ricardo-Garnet.kicad_sch]
2026-03-21 touching up and adding thermals for coating
    [Ricardo-Garnet.kicad_pcb, Ricardo-Garnet.kicad_sch, sensors.kicad_sch]
2026-05-12 added 2wire sensor and silkscreen
    [CAN.kicad_sch, Ricardo-Garnet.kicad_pcb, Ricardo-Garnet.kicad_sch, bldc_power.kicad_sch, boosts_sch.kicad_sch, power.kicad_sch, sensors.kicad_sch, usb.kicad_sch]
2026-05-12 tidied up repo
    [BLDC_4-2026-01-04-20-25-04.sch, CAN-2026-01-04-20-25-04.sch, Power-2026-01-04-20-25-04.sch, STM32F4 64LQFP-2026-01-04-20-25-04.sch, hall_filters-2026-01-04-20-25-04.sch, mosfets-2026-01-04-20-25-04.sch, temp-2026-01-04-20-25-04.sch]
2026-05-28 changes made post will's review
    [CAN.kicad_sch, Ricardo-Garnet.kicad_pcb, Ricardo-Garnet.kicad_sch, bldc_power.kicad_sch, boosts_sch.kicad_sch, mosfets.kicad_sch, power.kicad_sch, sensors.kicad_sch]
2026-06-08 fixed mosfet error
    [Ricardo-Garnet.kicad_pcb, bom.csv, designators.csv, mosfets.kicad_sch, positions.csv]
